theConductorCap/sections/hardware/PCB's/ParentBoardV1.png

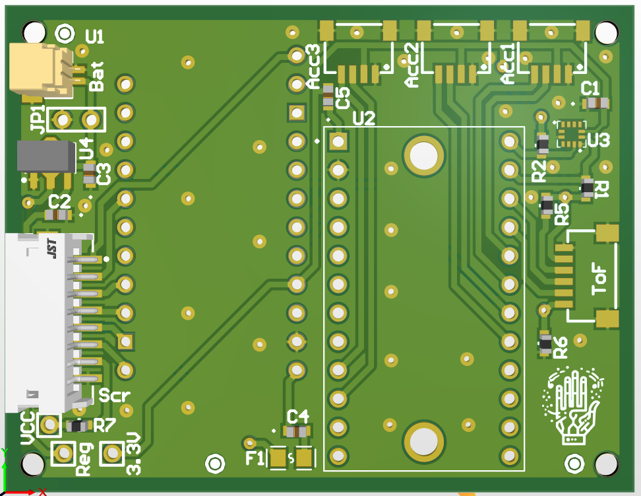
hardware/PCB's/ParentBoardV1.png
