theConductorCap/sections/README.md

# sections
These are the main sections of our capstone project
