theConductorCap/sections/coding/ConductorNetworkMiDiWriter/assets/image_1.png

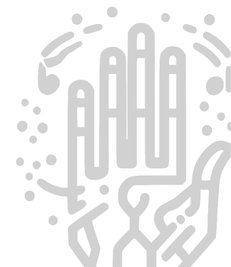
coding/ConductorNetworkMiDiWriter/assets/image_1.png
