theConductorCap/sections/hardware/enclosures/ChildBoardEnclosureV1.png

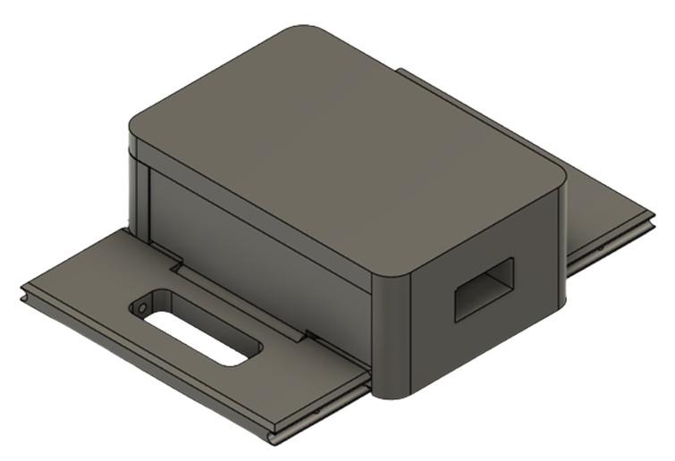
hardware/enclosures/ChildBoardEnclosureV1.png
