theConductorCap/sections/hardware/enclosures/ParentBoardEnclosureV1.png

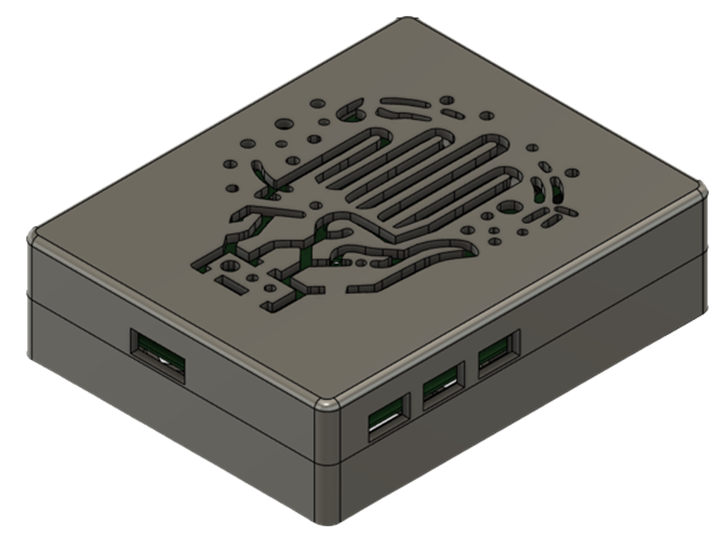
hardware/enclosures/ParentBoardEnclosureV1.png
