theConductorCap/sections/hardware/enclosures/TimeOfFlightEnclosureV1.png

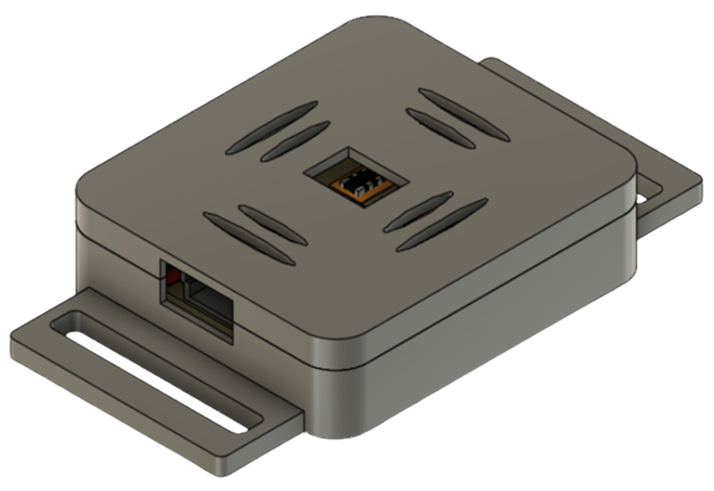
hardware/enclosures/TimeOfFlightEnclosureV1.png
