theConductorCap/sections/hardware/schematics/ChildBoardV1.jpg

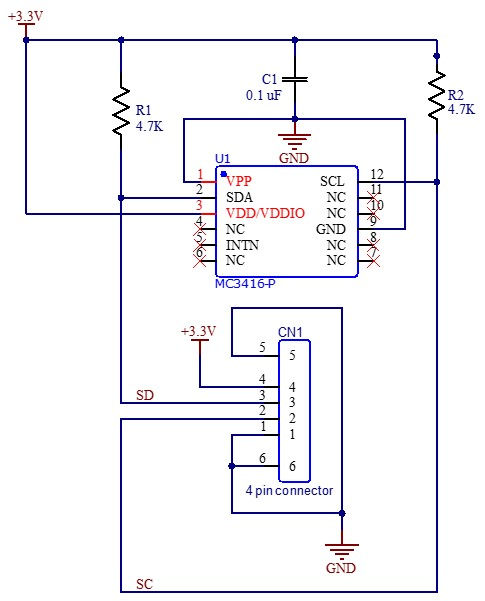
hardware/schematics/ChildBoardV1.jpg
