theConductorCap/sections/hardware/schematics/ChildBoardV2.png

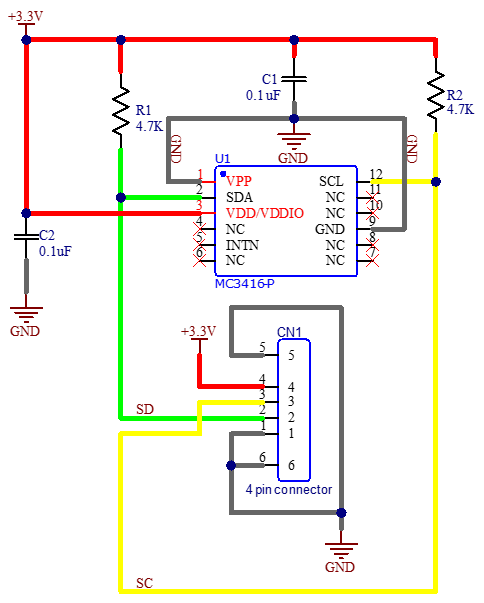
hardware/schematics/ChildBoardV2.png
