theConductorCap/sections/hardware/schematics/ParentBoardV2.png

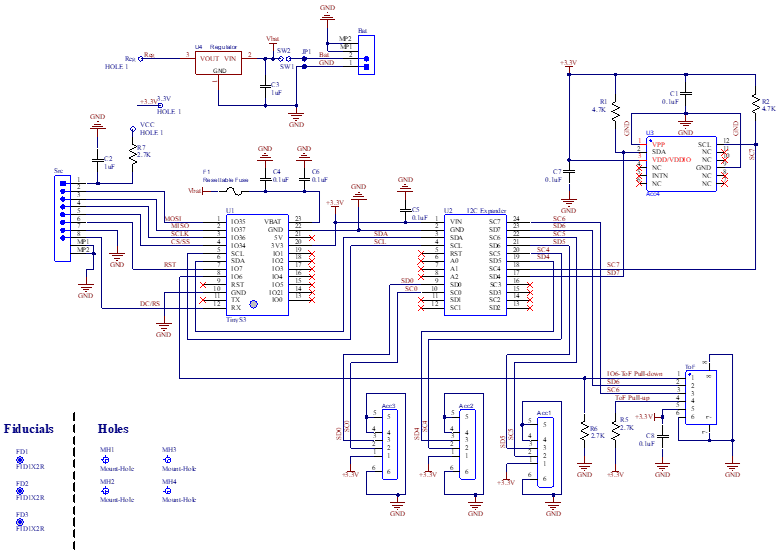
hardware/schematics/ParentBoardV2.png
