theConductorCap/sections/hardware/schematics/SchTheConductor1.png

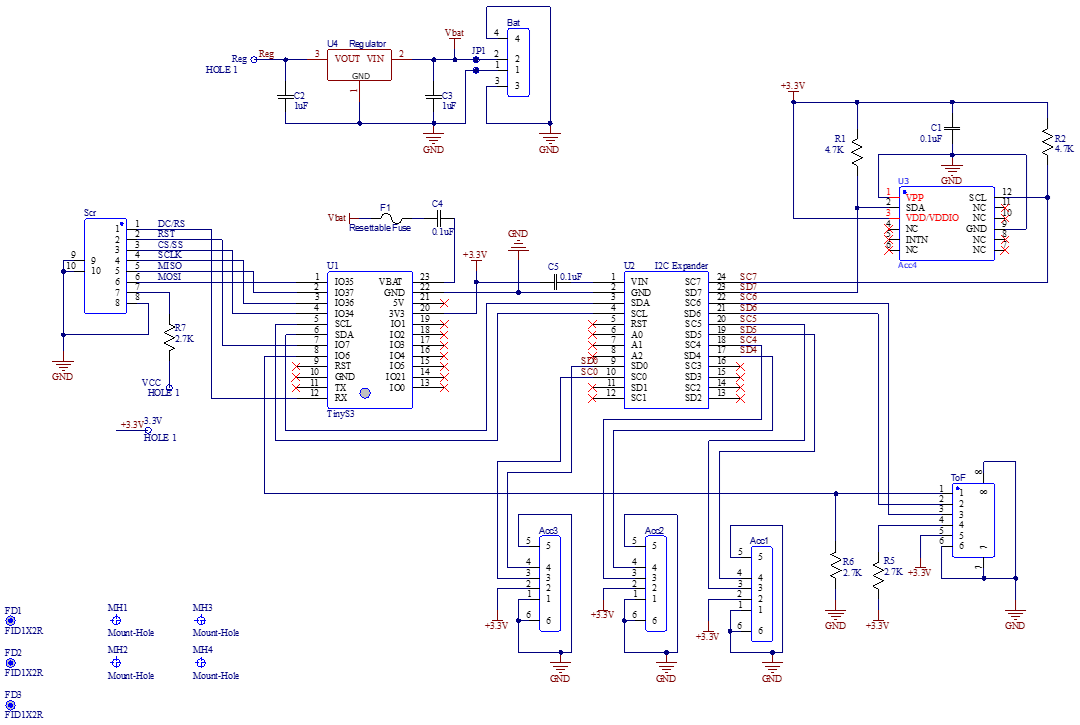
hardware/schematics/SchTheConductor1.png
