theConductorCap/sections/hardware/steps/PinHeaderMale.step

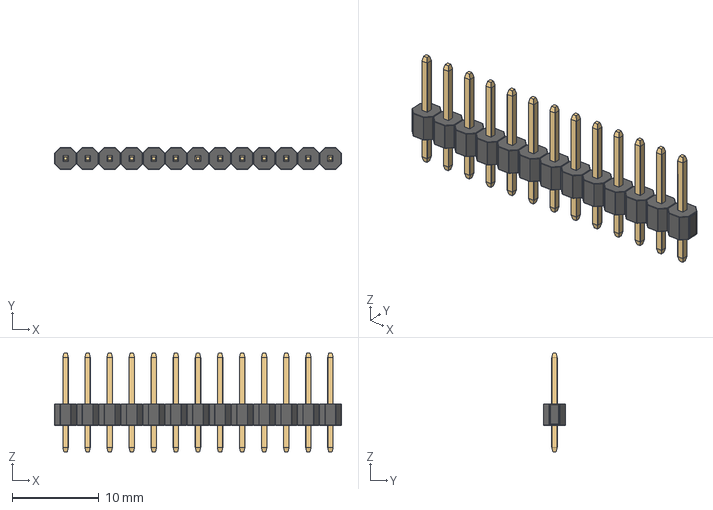
[picture p13: CAD file, 2023-11-14]
hardware/steps/PinHeaderMale.step
33.0 x 2.54 x 11.4 mm
Male Pin Header x 12
