theConductorCap/sections/hardware/steps/switchEG1201A.STEP

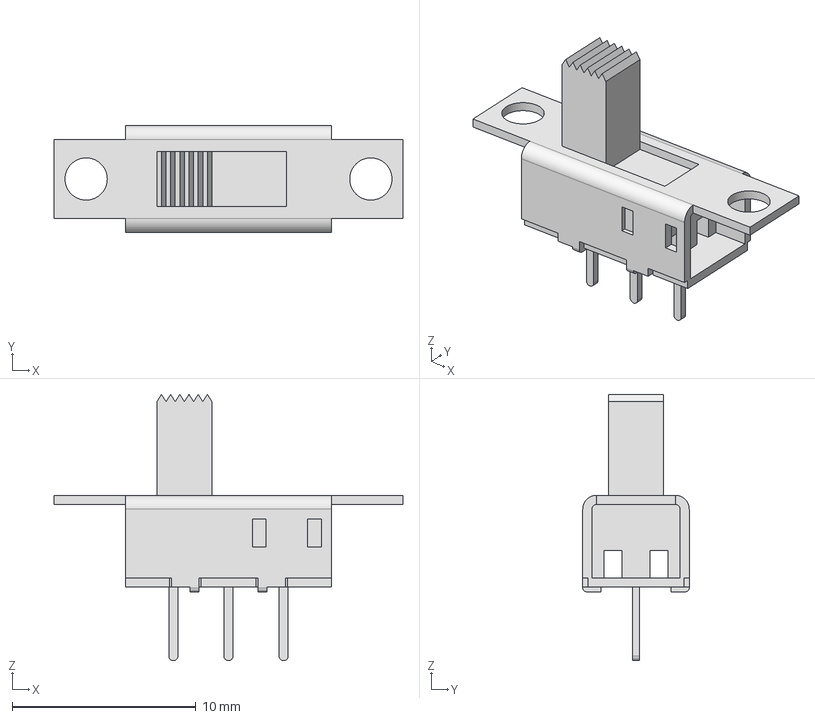
[picture p15: CAD file, 2023-11-14]
hardware/steps/switchEG1201A.STEP
19.0 x 5.80 x 14.5 mm
