theConductorCap/sections/hardware/steps/ParentBoardV1.step

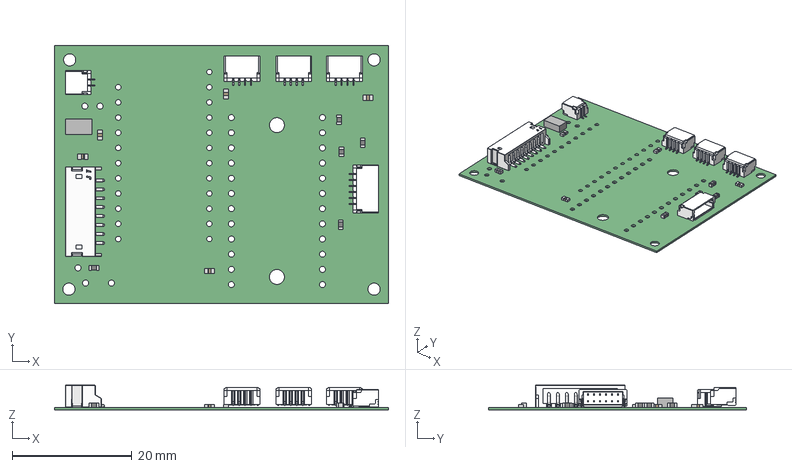
[picture p16: CAD file, 2023-11-14]
hardware/steps/ParentBoardV1.step
55.9 x 43.2 x 4.11 mm
SM02B-SRSS-TB-LF--SN---3DModel-STEP-56544_RGB16777215
JST
Pin1_Triangle
SM04B-SRSS-TB(LF)(SN)--3DModel-STEP-56544_RGB16777215 x 3
Extruded
SM06B-SRSS-TB-LF--SN---3DModel-STEP-56544_RGB16777215
