theConductorCap/sections/hardware/steps/ChildBoardV2.step

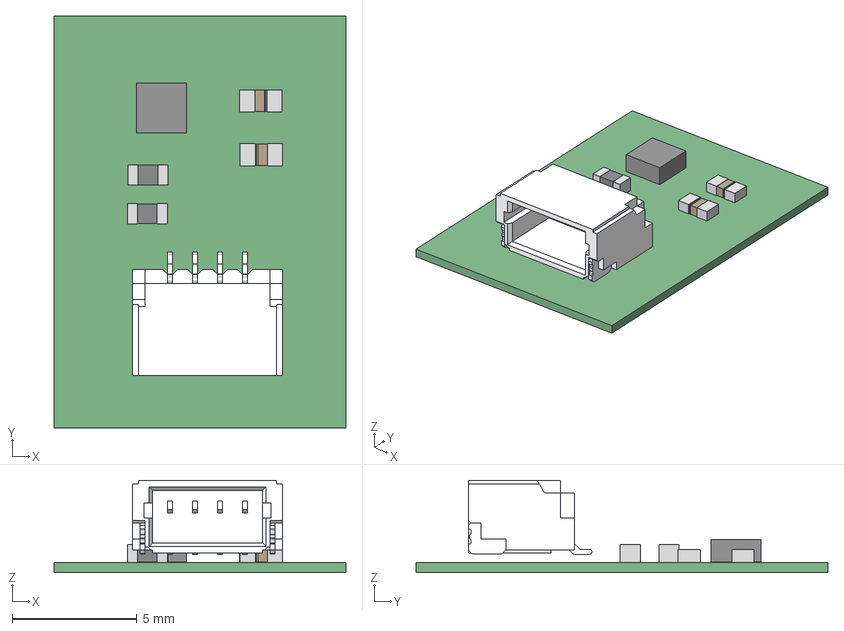
[picture p17: CAD file, 2023-11-14]
hardware/steps/ChildBoardV2.step
11.7 x 16.5 x 3.69 mm
MC3416_RGB4408131
SM04B-SRSS-TB(LF)(SN)--3DModel-STEP-56544_RGB16777215
