theConductorCap/sections/hardware/steps/ChildBoardV1.step

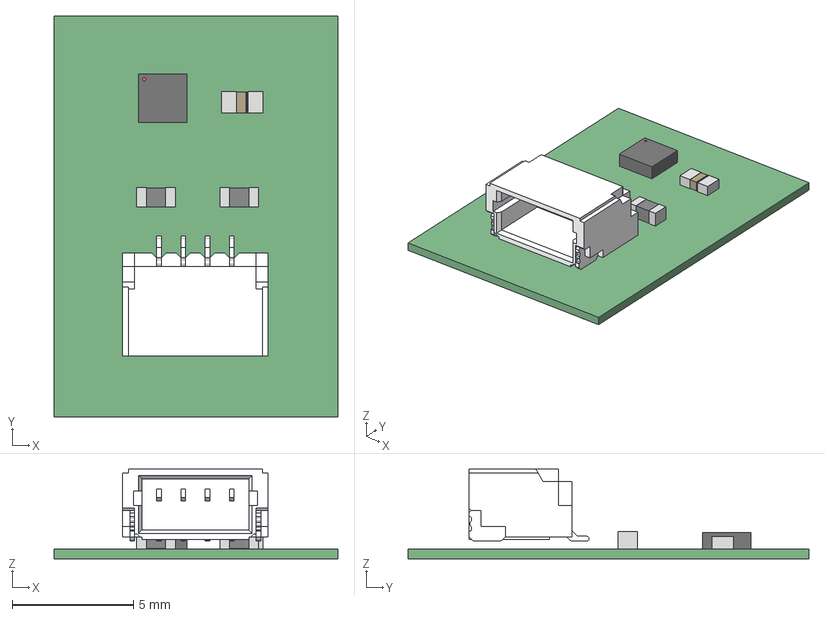
[picture p18: CAD file, 2023-11-14, an earlier design]
hardware/steps/ChildBoardV1.step
11.7 x 16.5 x 3.69 mm
ACCE (1)
SM04B-SRSS-TB(LF)(SN)--3DModel-STEP-56544_RGB16777215 (1)
