theConductorCap/sections/(list of files, drawings)

Other design files:
hardware/PCB's/ChildBoardV1.PcbDoc
hardware/PCB's/ChildBoardV2.PcbDoc
hardware/PCB's/ParentBoardV2.PcbDoc
hardware/schematics/ParentBoardV2.SchDoc
hardware/schematics/TheConductorChildBoardV2.SchDoc
