theConductorCap/sections/(commit log)

2023-11-14 schematics submission
    Parent and child board submission
2023-11-14 BOM submissions
    submission of bill of materials
    [ChildBoardv1.xlsx, ChildBoardv2.xlsx, ParentBoardv1.xlsx, ParentBoardv2.xlsx]
